ernerdl/adept57-trackball/hardware/stl/bottom-shell-57.stl

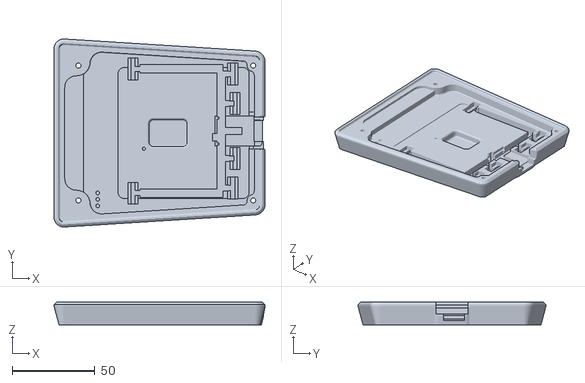
[picture p1: CAD file, 2026-11-06]
hardware/stl/bottom-shell-57.stl
127.2 x 113.4 x 13.8
