ernerdl/adept57-trackball/hardware/stl/bearing-dowel-3.05x9.8-x4.stl

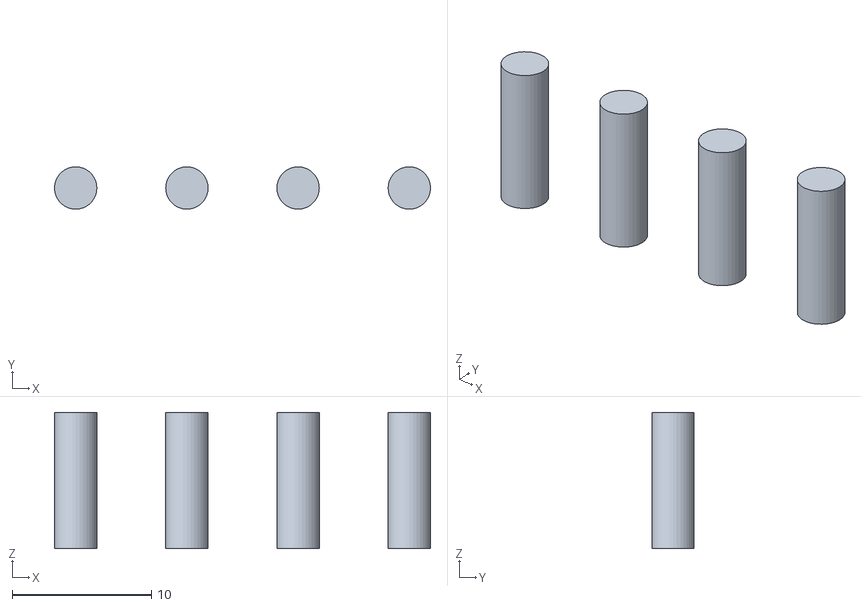
[picture p2: CAD file, 2026-11-06]
hardware/stl/bearing-dowel-3.05x9.8-x4.stl
27.0 x 3.05 x 9.80
