ernerdl/adept57-trackball/hardware/stl/top-shell-57.stl

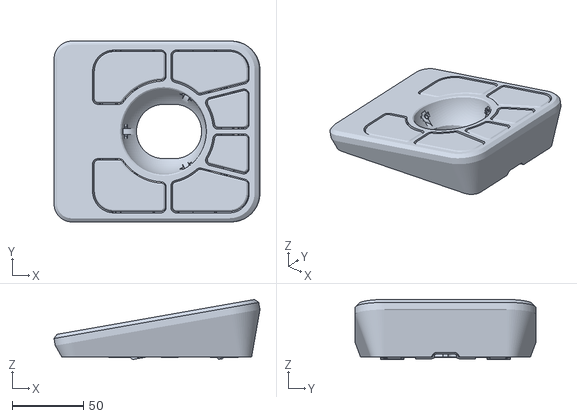
[picture p3: CAD file, 2026-11-06]
hardware/stl/top-shell-57.stl
144.7 x 127.0 x 42.2
