ernerdl/adept57-trackball/(list of files, cad)

Other CAD files:
hardware/source/bottom-shell-57.f3d
