ernerdl/adept57-trackball/(commit log)

2026-11-06 adept57-trackball: Ploopy Adept türevi 57mm trackball + RP2040 USB köprüsü
    - firmware/: RP2040-Zero köprüsü (PIO-USB host + USB device), WebHID ayar
    sayfası, tuşsuz güncelleme, cihaz içi olay günlüğü — GPLv3
    - hardware/: Ploopy Adept'ten türetilmiş kasa (1.27x, MR63ZZ yuvaları,
    switch cepleri, Zero yatağı) — CERN-OHL-S-2.0
    [bearing-dowel-3.05x9.8-x4.stl, bottom-shell-57.f3d, bottom-shell-57.stl, top-shell-57.stl]
2026-11-11 Firmware: arm the watchdog before clock setup; add USB event recorder
    A burst of resets could leave the board absent from USB until it was
    replugged: the watchdog was armed only after tud_init, so a boot that
    stalled earlier (crystal/PLL, flash, core 1) never recovered.
    - early watchdog from a runtime-init hook that runs before clock setup
    - log event 14 records each rescued boot
    - PICO_XOSC_STARTUP_DELAY_MULTIPLIER=64
    - drop pico_bootsel_via_double_reset (a reset burst could strand the
    board in the bootloader; updates use the HID packet anyway)
    - tools/usb-kaydedici.sh: optional macOS helper that keeps a permanent
    record of USB connect/disconnect events
    Settings format is unchanged.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
    [main.c]
2026-11-11 Firmware: black box — important events are also kept in flash
    The RAM log is lost on a full power loss, which is exactly when it is
    needed. A ring of eight flash sectors below the settings sector now keeps
    about 1,900 records (boot reasons, host connect/disconnect, supervisor
    resets), each with the wall-clock time supplied by the computer.
    - erase only at boot before core 1 starts; one page program at runtime
    - records flushed before every deliberate reset
    - measured quirk: this board's flash (JEDEC 68 10 15) does not preserve
    the rest of a page on a partial program, so every write is
    read-modify-write and sector headers sit on their own page
    - config channel: 0x08 raw read, 0x09 set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
    [main.c]
2026-11-12 Firmware: fix handshake race in the PIO-USB host that broke enumeration
    The mouse board sometimes failed to enumerate, leaving the ball dead until the
    supervisor reset the bridge (4-12 s, on up to half of all boots depending on
    the build).
    Cause: pio_usb_bus_wait_handshake in Pico-PIO-USB checks "byte in FIFO?" and
    then "packet ended?". When the second handshake byte lands between the two
    checks the loop leaves on end-of-packet with the byte still in the FIFO, so
    the ACK is treated as missing. Three in a row fail the transfer. How often it
    happens depends on the entry timing of the function, which shifts with every
    build.
    Fix: the linker's --wrap replaces the function with a copy that, onc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
    [main.c]
